adithya-in/Stepper-Motor-shield/README.md

# Stepper Motor Shield — PID Position Control + S-Curve

PIC32MK0512MCJ064 firmware driving a NEMA17 stepper via TB6600 driver with AS5047U
magnetic encoder feedback. Controlled over USB serial (115200 baud) or web dashboard.

**Achieved accuracy: ±1–3 encoder counts = 0.022°–0.066°** (limited by encoder noise floor).

**Clock speed note:** All testing done at **48 MHz** SYSCLK (SPLL from 8 MHz FRC). Target production clock is **10 MHz** (external crystal or lower PLL) — testing pending.

## Project Status

| Area | Status |
|---|---|
| **Firmware** | **Complete** — v6.2.0 tested and verified at 48 MHz (SPLL, 115200 baud, auto-tune capped) |
| **Hardware testing** | **Complete** — NEMA17 + TB6600 characterized at 24V and 31V (see test data below) |
| **Schematic** | **Complete** — KiCad schematic for PIC32MK + TMC2660 + AS5047D + CAN + USB-C (`hardware/Motorshield v6.kicad_sch`) |
| **PCB layout** | **In progress** — routing and layout yet to be finished |
| **10 MHz migration** | **Pending** — clock-dependent formulas need recalculation and retesting |

## Quick Start

```bash
# Flash firmware (via MDB)
rm -rf ~/.mplabcomm
/Applications/microchip/mplabx/v6.30/mplab_platform/bin/mdb.sh flash.mdb

# Connect serial
screen /dev/cu.usbmodemBUR2143200772 115200

# Start dashboard
cd dashboard && npm install && node server.js
# → http://localhost:3000
```

**Power cycle the PKoB4** (unplug/replug USB) after flashing — VCOM gets stuck otherwise.

## Serial Commands

All commands support both **legacy** and **Phase 1** formats. Legacy commands are preserved
so the dashboard and existing scripts continue working.

### Legacy Commands

| Command | Action | Range |
|---|---|---|
| **Position Control** | | |
| `T=<pos>` | Move to absolute position (encoder counts, negative OK) | ±2M |
| `STOP` | Emergency stop — hold position, reset integrator | — |
| `HOME` | Set current position = 0 AND target = 0 | — |
| `ZERO` | Set current position = 0 (leave target unchanged) | — |
| `CLEAR` | Clear fault, re-init motor driver | — |
| **Open-Loop Motor Test** | | |
| `ON` | Enable motor + start spinning at last speed (default 100) | — |
| `OFF` | Disable motor, exit open-loop mode | — |
| `CW` | Set direction clockwise | — |
| `CCW` | Set direction counter-clockwise | — |
| `SPEED=<n>` | Set step rate for open-loop mode | 10–100000 |
| **Motion Profile** | | |
| `MAXV=<n>` | Max velocity | ≥1 steps/s |
| `ACCEL=<n>` | Max acceleration | ≥100 steps/s² |
| `JERK=<n>` | Max jerk (S-curve smoothness) | ≥1000 steps/s³ |
| `PROFILE=S` | S-curve — jerk-limited smooth transitions | — |
| `PROFILE=T` | Trapezoidal — instant acceleration changes | — |
| **PID Tuning** | | |
| `KP=<n>` | Proportional gain | 0–99999 |
| `KI=<n>` | Integral gain | 0–99999 |
| `KD=<n>` | Derivative gain | 0–99999 |
| `TOL=<n>` | At-target tolerance | 0–1000 counts |
| `FT=<n>` | Fault threshold (checked only at rest) | 1–100000 counts |
| **Diagnostics** | | |
| `GET` | One-shot config dump | — |
| **Multi-Point Queue** | | |
| `Q=<pos>,<pos>,...` | Load queue (2–32 points) and start sequential execution | — |
| `DWELL=<ms>` | Set inter-point dwell delay (0–30000 ms) | — |
| `QSTOP` | Abort queue mid-execution | — |

### Phase 1 Commands (Colon-Separated)

| Command | Action | Example |
|---|---|---|
| **Move** | | |
| `m:<speed>:<pos>` | Move to position at given speed (sets MAXV temporarily) | `m:20000:80000` |
| **Enable** | | |
| `en:1` | Enable closed-loop servo (hold current position) | `en:1` |
| `en:0` | Disable motor (release) | `en:0` |
| **Zero** | | |
| `z` | Set current encoder position as zero | `z` |
| **Coil Current (stored)** | | |
| `i:<mA>` | Set coil current limit (stored value, 100–5000 mA) | `i:800` |
| **Microstep (stored)** | | |
| `us:<n>` | Set microstep setting (1/2/4/8/16/32) | `us:16` |
| **PID Gains** | | |
| `pid:<kp>:<ki>:<kd>` | Set proportional, integral, derivative gains | `pid:50:5:10` |
| **Telemetry** | | |
| `tlm:1:<ms>` | Enable status stream at N ms period | `tlm:1:50` |
| `tlm:0` | Disable status stream | `tlm:0` |
| **Multi-Point Queue** | | |
| `q:<pos1>:<pos2>:...` | Load queue (2–32 points) and start sequential execution | `q:10000:20000:30000` |
| `dwell:<ms>` | Set inter-point dwell delay | `dwell:1000` |
| `qstop` | Abort queue mid-execution | `qstop` |
| **Status Query** | | |
| `st?` | One-shot status: position, velocity, error, flags | `st?` |

### Response Format

All commands acknowledge:
```
OK <command>=<value>\r\n
```
or
```
ERR UNKNOWN\r\n
```

### Automatic Status Stream (10 Hz default)

```
P:<position>,E:<error>,V:<velocity>,T:<target>,F:<fault>,M:<moving>,A:<at_target>,Q:<qidx>,QL:<qlen>\r\n
```

Set period with `tlm:1:<ms>` (10–10000 ms), disable with `tlm:0`.

### st? Response (one-shot)

```
p:<position>,v:<velocity>,e:<error>,f:<flags>\r\n
```

Flags bitmask:
- bit 0: fault
- bit 1: moving
- bit 2: at_target
- bit 3: open_loop

### GET Response

```
T=<target>,P=<position>,E=<error>,V=<velocity>,KP=<kp>,KI=<ki>,KD=<kd>,MAXV=<maxv>,ACCEL=<accel>,JERK=<jerk>,TOL=<tol>,FT=<ft>,PROFILE=<S|T>,I=<mA>,US=<microstep>,QLEN=<n>,QIDX=<n>,DWELL=<ms>\r\n
```

## Usage Examples

### Basic Move

```
> en:1           Enable servo (holds current position)
OK en:1
> m:20000:50000  Move to position 50000 at 20000 steps/s
OK m:20000:50000
> st?            Check status
p:50000,v:0,e:0,f:4
```

### Snappy Move (profile feed-forward)

The motor runs at full commanded speed until the stopping distance
(`v² / (2·accel_limit)`) from target, then decelerates hard. The PID
acts as a trim, active only near the target.

```
> PROFILE=T      Trapezoidal profile (instant accel changes)
> ACCEL=500000   Fastest ramp
> MAXV=50000     Top speed
OK PROFILE=T
OK ACCEL=500000
OK MAXV=50000
> m:50000:100000 Move at 50000 steps/s — reaches full speed in ~100ms
OK m:50000:100000
```

### PID Tuning

```
> pid:30:2:5     Set Kp=30, Ki=2, Kd=5
OK pid:30:2:5
> GET            Verify all params
T=10000,P=10000,E=0,V=0,KP=30,KI=2,KD=5,...
```

### Auto-Tune

Relay-based Ziegler-Nichols PID tuning. The motor oscillates around a target, measures ultimate gain (Ku) and period (Tu), then applies:

```
Kp = 0.6 × Ku × 100    (capped at 10000)
Ki = 1.2 × Ku / Tu      (capped at 1000)
Kd = 0.075 × Ku × Tu    (capped at 10000)
```

Send `TUNE` to start. The motor will:
1. Move to current position + 3000 counts
2. Begin relay oscillation (±3000 steps/s relay velocity)
3. After 4+ full cycles, compute PID gains
4. Report: `OK TUNE:Kp=...,Ki=...,Kd=...,amp=...,Tu=...`
5. Return to original target

Caps on auto-tune output prevent excessive gains that cause oscillation — particularly Kd, which can destabilize the motor at high values.

### Telemetry Stream

```
> tlm:1:200      Stream every 200ms
OK tlm:1:200
P:5000,E:-2,V:150,T:5000,F:0,M:0,A:1
P:5000,E:-1,V:0,T:5000,F:0,M:0,A:1
...
> tlm:0          Stop streaming
OK tlm:0
```

### Multi-Point Queue

```
> DWELL=2000     Set 2 second pause between points
OK DWELL=2000
> Q=10000,30000,50000,20000  Load 4-waypoint queue
OK Q=4 points
> ...automatically moves: 10000 → 30000 → 50000 → 20000...
                Each arrival: 2s dwell → next move
> QSTOP          Abort mid-sequence
OK QSTOP
```

Queue is automatically aborted on any manual move (`T=`, `m:`), `STOP`, `OFF`, or `en:0`.

## Accuracy

The system achieves **±1–3 encoder counts** following error at rest.

| Domain | Value |
|---|---|
| 1 encoder count | 360° / 16384 = **0.022°** |
| Typical error | 1–3 counts = **0.022°–0.066°** |
| AS5047U non-linearity | ±0.05° = ~±2 counts |
| With 10mm leadscrew | 1 count ≈ **0.6 µm** |

The error is at the encoder's own noise floor. No further improvement possible
without a higher-resolution encoder.

## Non-Volatile Config

All tuning parameters (Kp, Ki, Kd, max_vel, accel_limit, jerk_limit, tolerance,
fault_thr, profile, coil_current, microstep) are automatically saved to the last
flash page when changed. Persist across power cycles.

- **Flash address**: last page of 512KB (0x1D07F000)
- **Save strategy**: 100ms debounce after last parameter change
- **Integrity**: magic word (0xBEADC0DE) + XOR checksum validated on load
- **Defaults**: used if flash is blank or corrupted

## Motion Profiles

### S-Curve (`PROFILE=S`)
Jerk-limited acceleration:

```
acceleration:  ──/‾‾‾‾‾‾\──  (ramps up/down at JERK rate)
velocity:      ──/‾‾‾‾‾‾\──  (rounded S-shaped transitions)
```

- Jerk limits how fast acceleration changes
- Lower JERK = smoother but slower moves
- Three phases: smooth accel → coast → smooth decel

### Trapezoidal (`PROFILE=T`)
Instant acceleration changes:

```
acceleration:  ──╯‾‾‾‾‾‾╰──  (square wave)
velocity:      ──/‾‾‾‾‾‾\──  (sharp V-shaped ramps)
```

- ACCEL limits the slope of velocity ramps
- Reaches target speed faster than S-curve at same ACCEL
- Higher mechanical stress at transitions

### Profile Feed-Forward (v5.1.2+)

The velocity target is computed from a motion profile, not from PID error.
The motor maintains full commanded speed until the stopping distance from target,
then decelerates at the ACCEL rate. PID adds only a small trim for fine positioning.

```
raw_vel = profile_velocity(error) + pid_trim
profile_vel = max_vel (if far) or linear decel ramp (near target)
pid_trim    = (Kp·error + Ki·integral + Kd·derivative) / 100
```

Anti-windup: integral resets during moves, only active near target.
Auto-tune output capped at Kp≤10000, Ki≤1000, Kd≤10000 to prevent excessive gains.

## Wiring

See [PINOUT.md](docs/PINOUT.md) for complete pin mapping.

### TB6600 Common-Anode Summary

| TB6600 | PIC32MK | Note |
|---|---|---|
| PUL+ | RPB15 (OC1 PWM) | Step pulses, 50% duty |
| DIR+ | RPB14 (GPIO) | LOW=CW, HIGH=CCW |
| ENA+ | RPB13 (GPIO) | **LOW=enable**, HIGH=disable |
| PUL-/DIR-/ENA- | GND | All three tied together |

### TB6600 DIP Switches
- S1/S2/S3: per motor current rating
- S4/S5/S6: S4 ON, S5 ON, S6 ON = 1/32 microstep (6400 steps/rev)

## Dashboard

Web-based UI on port 3000:

```
dashboard/
├── server.js          # Express + WebSocket + serial bridge
├── package.json
└── public/
    ├── index.html     # UI layout
    ├── app.js         # Client logic
    └── styles.css     # Dark theme
```

### Features
- Position display: target / actual with bar indicator
- Status: error, velocity, fault, moving, at-target
- Motor Test card: ON/OFF, CW/CCW, speed slider (up to 50000 steps/s)
- PID sliders: Kp (0–50000), Ki (0–10000), Kd (0–50000)
- Auto-tune button: relay-based Ziegler-Nichols tuning, results shown with slider label sync
- TLM toggle: enable/disable telemetry stream
- Motion Profile: S-curve / Trapezoidal toggle
- ACCEL and JERK number inputs with Set buttons
- MAXV, Tolerance, Fault Threshold inputs
- GET response parsing: position, error, velocity, TOL, FT fields

### Architecture

```
Firmware (PIC32MK) ←→ Serial (115200) ←→ server.js ←→ WebSocket ←→ browser
```

## Firmware Architecture

**Clock:** Currently runs at **48 MHz** (SPLL from 8 MHz FRC). Target for production: **10 MHz** — all clock-dependent formulas (core timer, UART baud, step pulse generation, auto-tune timing) will need recalculation. Testing at 10 MHz is pending.

| Component | Peripheral | Rate | Purpose |
|---|---|---|---|
| Position loop | Timer3 ISR | 1 kHz | Profile → PID trim → smoother → velocity |
| Step generation | OC1 + Timer2 PWM | Variable | Hardware step pulses, 50% duty |
| Encoder | QEI1 | Continuous | AS5047U ABI, 16384 counts/rev |
| UART | UART1 | 115200 baud | Command + telemetry |
| NVM flash | Self-write | On change | Config storage (last flash page) |
| Status stream | Main loop | Configurable | P:E:V:T:F:M:A:Q:QL telemetry |

### Algorithm

```
error = target_pos - encoder_read()

// Profile feed-forward velocity
stop_dist = max_vel² / (2 × accel_limit)     // stopping distance
if abs(error) > stop_dist:
    profile_vel = max_vel × sign(error)       // cruise
else:
    profile_vel = max_vel × error / stop_dist // decel ramp

// PID trim
pid_trim = (Kp×error + Ki×integral + Kd×derivative) / 100

// Combined, fed into accel/jerk smoother
raw_vel = profile_vel + pid_trim

// Accel/jerk smoother → sm_vel → motor steps
```

### Resolution

| Aspect | Value |
|---|---|
| Motor steps/rev | 200 (NEMA17, 1.8°/step) |
| Microstep setting | **1/32** (S4 ON, S5 ON, S6 ON) |
| Steps per revolution | **6400** |
| Encoder PPR | 4096 (AS5047U) |
| Encoder counts/rev (4× QEI) | 16384 |
| Position resolution | 360° / 16384 = **0.022°** per count |

## Voltage-Dependent Limits

At **1/32 microstep** (6400 steps/rev). Firmware accepts any positive value; the
practical limit is set by the motor driver and supply voltage. Empirically determined
guidelines (no load, idle condition):

| Supply Voltage | MAXV (steps/s) | MAXV (RPM) | ACCEL (steps/s²) | Notes |
|---|---|---|---|---|
| 31V | 280,000 | 2,625 | 2,700,000 | Best reliable: 1725 mm/s, Kp=2121 Ki=46. All tests at 48 MHz — 10 MHz testing pending |
| 24V | 250,000 | 2,344 | 3,200,000 | At ≥2.5A coil current, smooth with heating. All tests at 48 MHz — 10 MHz testing pending |
| 12V | 50,000 | 469 | 5,000,000 | Reduced max velocity. All tests at 48 MHz — 10 MHz testing pending |

**31V characterization** (from `docs/TESTS.md`):
- MAXV 300k with 3.2M ACCEL reaches 1902 mm/s (Kp 50–1000, Ki=5, Kd=0)
- Kp >~2000 with Ki > 0 causes oscillation at 31V; best results use moderate Kp
- Trade-off: higher MAXV requires lower ACCEL and vice versa
- Kd was 0 in all 31V tests — derivative not needed with proper Kp/Ki balance

**RPM formula:** `RPM = (steps/s × 60) ÷ steps_per_rev` where `steps_per_rev = 6400` at 1/32.

## Releases

| Tag | Date | Description |
|-----|---|---|
| **v6.2.0** | 2026-06-20 | **Auto-tune caps restored, 31V test data.** Kp≤10000/Ki≤1000/Kd≤10000 caps restored on auto-tune output (prevents oscillation from excessive gains). 31V characterization: 280k MAXV / 2.7M ACCEL / 1725 mm/s reliable belt speed. |
| **v6.1.0** | 2026-06-17 | **SPLL clock (48 MHz), 115200 baud, no command limits.** FRC→SPLL migration. All clock timing fixed. MAXV/ACCEL/JERK upper limits removed. Dashboard TLM toggle. |
| **v6.0.0** | 2026-06-15 | **Phase 1 complete.** `docs/BUGS_AND_LESSONS.md` — full 24+ bug knowledge base. Dashboard activeElement input protection. |
| **v5.2.0** | 2026-06-12 | Multi-point queue (Q=/q:), DWELL, QSTOP, dashboard queue card |
| **v5.1.4** | 2026-06-12 | Dashboard UI ranges match firmware; ACCEL/JERK number inputs; accuracy ±1–3 counts |
| **v5.1.3** | 2026-06-12 | Snappier defaults: MAXV=5000, ACCEL=50000, JERK=500000; ranges increased 5–10× |
| **v5.1.2** | 2026-06-12 | Profile feed-forward velocity; full speed until stopping distance; PID trim only near target |
| **v5.1.1** | 2026-06-12 | NVM flash config: all settings persist across power cycles |
| **v5.1.0** | 2026-06-12 | Phase 1 commands (colon-separated), Kd, configurable telemetry |
| **v5.0.1** | 2026-06-11 | Trapezoidal profile, dashboard toggle, ACCEL/JERK commands |
| **v5.0.0** | 2026-06-11 | PID + S-curve + open-loop test + 6 bug fixes |
| **v4.0.0** | 2026-06-10 | UART serial fixes |
| **v3.1.0** | 2026-06-09 | Open-loop speed control |
| **v3.0.0** | 2026-06-09 | Closed-loop position control |
| **v2.0.0** | 2026-06-09 | Stepper control + encoder |
| **v1.0.0** | 2026-06-08 | Encoder-only firmware |
