adithya-in/Stepper-Motor-shield/hardware/motorshield v6.kicad_pcb

## KiCad design hardware/motorshield v6.kicad_pcb (2026-06-29)

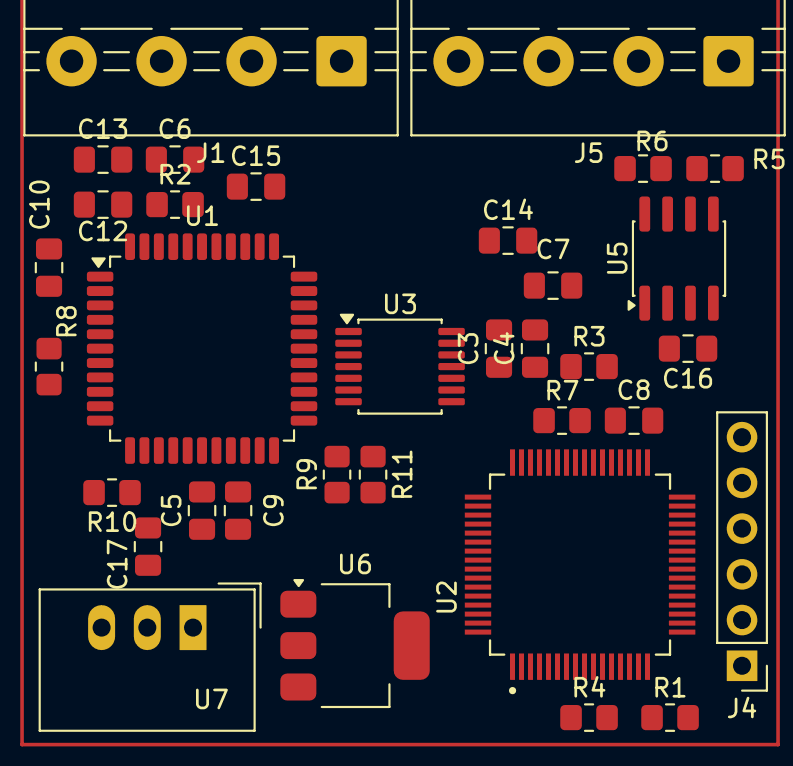
[picture p1: board motorshield v6.kicad_pcb from above]

Board: 2 copper layers, 34 parts (0 on the bottom side), 42 nets, no tracks yet.

Parts:
C3: 10 µF; C_0805_2012Metric_Pad1.18x1.45mm_HandSolder
C4, C5, C6: 0.1 µF; C_0805_2012Metric_Pad1.18x1.45mm_HandSolder
C7, C8: 21 pF; C_0805_2012Metric_Pad1.18x1.45mm_HandSolder
C9, C12, C13: 1µF; C_0805_2012Metric_Pad1.18x1.45mm_HandSolder
C10: 100nF; C_0805_2012Metric_Pad1.18x1.45mm_HandSolder
C14, C16: 100nF/50V; C_0805_2012Metric_Pad1.18x1.45mm_HandSolder
C15: 220nF; C_0805_2012Metric_Pad1.18x1.45mm_HandSolder
C17: 470nF; C_0805_2012Metric_Pad1.18x1.45mm_HandSolder
J1, J5: Conn_01x04; TerminalBlock_MaiXu_MX126-5.0-04P_1x04_P5.00mm
J4: Conn_01x06; PinHeader_1x06_P2.54mm_Vertical
R1, R4, R7: 1K; R_0805_2012Metric_Pad1.20x1.40mm_HandSolder
R2: 10K; R_0805_2012Metric_Pad1.20x1.40mm_HandSolder
R3: 0 Ω; R_0805_2012Metric_Pad1.20x1.40mm_HandSolder
R5, R6: 120; R_0805_2012Metric_Pad1.20x1.40mm_HandSolder
R8, R11: 0R075; R_0805_2012Metric_Pad1.20x1.40mm_HandSolder
R9, R10: 10R; R_0805_2012Metric_Pad1.20x1.40mm_HandSolder
U1: TMC2660; LQFP-44_10x10mm_P0.8mm
U2: PIC32MK0512MCJ064T-I_PT; PIC32MK0512MCJ064-I_PT
U3: AS5047D; TSSOP-14_4.4x5mm_P0.65mm
U5: MCP2562-E-SN; SOIC-8_3.9x4.9mm_P1.27mm
U6: AMS1117-3.3; SOT-223-3_TabPin2
U7: TSR_1-2450; Converter_DCDC_TRACO_TSR-1_THT

Connections:
+3.3V: C3.1, C4.1, C5.1, C9.1, C16.1, J4.2, R2.2, U1.40 (VCC_IO), U2.10 (VDD), U2.19 (AVDD), U2.26 (VDD), U2.38 (VDD), U2.57 (VDD), U3.12 (VDD3V3), U5.5 (Vio), U6.2 (VO)
+5V: U6.3 (VI), U7.3 (Vout)
+40V: C10.2, C12.1, C13.1, C14.1, C15.1, J5.4, U1.4 (VSA), U1.30 (VSB), U1.36 (VS), U3.11 (VDD), U7.1 (Vin)
/CAN1_RX: U2.36 (AN46/CVD46/RPA14/RA14), U5.4 (RXD)
/CAN1_TX: U2.37 (AN47/CVD47/RPA15/RA15), U5.1 (TXD)
/CANH: J5.2, R6.2
/CANL: J5.1, R5.2
/CSN: U1.18 (~CS), U2.32 (FLT15/RPB4/SCL2/RB4)
/Clock: U2.15 (PGD3/VREF-/OA2IN-/AN2/C2IN1-/RPB0/CTED2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), U3.2 (CLK)
/DIR: U1.41 (DIR), U2.2 (RPB14/PWM1H/RB14)
/ENABLE: U1.19 (~EN), U2.63 (RPB13/PWM2L/CTPLS/RB13)
/Encoder A: U2.4 (AN19/CVD19/RPG6/PWM7L/RG6), U3.7 (A)
/Encoder B: U2.5 (AN18/CVD18/RPG7/PWM7H/RG7), U3.6 (B)
/MCLR: J4.1, R1.2, U2.7 (~MCLR)
/Miso: U2.17 (PGC1/OA1IN+/AN4/C1IN1+/C1IN3-/C2IN3-/RP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), U3.3 (MISO)
/Mosi: U2.16 (PGC3/OA1OUT/VREF+/AN3/C1IN4-/C4IN2-/RPB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), U3.4 (MOSI)
/Motor A+: J1.4, U1.2 (OA1), U1.3 (OA1), U1.7 (OA1), U1.8 (OA1)
/Motor A-: J1.3, U1.5 (OA2), U1.6 (OA2), U1.10 (OA2), U1.11 (OA2)
/Motor B+: J1.2, U1.26 (OB1), U1.27 (OB1), U1.31 (OB1), U1.32 (OB1)
/Motor B-: J1.1, U1.23 (OB2), U1.24 (OB2), U1.28 (OB2), U1.29 (OB2)
/NC: J4.6, U1.1 (n.c.), U1.33 (n.c.), U3.8 (W/PWM), U3.9 (V), U3.10 (U), U3.14 (I/PWM)
/OSCI: C8.1, U2.39 (OSCI/CLKI/AN49/CVD49/RPC12/RC12)
/OSCO: R3.2, U2.40 (OSCO/CLKO/RPC15/RC15)
/SCK: U1.16 (SCK), U2.43 (PGD2/RPB5/SDA1/RB5)
/SDI: U1.15 (SDI), U2.46 (OA5OUT/AN25/CVD25/C5IN4-/RPB7/SCK1/INT0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)
/SDO: U1.14 (SDO), U2.44 (PGC2/RPB6/SCL1/RB6)
/STEP: U1.42 (STEP), U2.3 (RPB15/PWM1L/RB15)
/cs: U2.18 (PGD1/OA1IN-/AN5/CTCMP/C1IN1-/RTCC/RPB3/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), U3.1 (~CS)
GND: C3.2, C4.2, C5.2, C6.2, C7.2, C8.2, C9.2, C10.1, C12.2, C13.2, C14.2, C16.2, C17.1, J4.3, J5.3, R4.1, R7.2, R8.2, R11.2, U1.17 (GND), U1.39 (GND), U1.43 (TST_MODE), U1.44 (GND), U2.9 (VSS), U2.20 (AVSS), U2.25 (VSS), U2.41 (VSS), U2.56 (VSS), U3.5 (TST), U3.13 (GND), U5.2 (VSS), U5.8 (STBY), U6.1 (GND), U7.2 (GND)
unnamed: C7.1, R3.1
unnamed: C6.1, R1.1, R2.1
unnamed: C17.2, U1.13 (5VOUT)
unnamed: R8.1, R10.2, U1.9 (BRA)
unnamed: R9.2, R11.1, U1.25 (BRB)
unnamed: R10.1, U1.12 (SRA)
unnamed: R9.1, U1.22 (SRB)
unnamed: C15.2, U1.35 (VHS)
unnamed: R4.2, U2.1 (TCK/RPA7/PWM4L/RA7), U2.11 (AN10/CVD10/RPA12/FLT13/RA12), U2.12 (AN9/CVD9/RPA11/FLT14/RA11), U2.13 (OA2OUT/AN0/C2IN4-/C4IN3-/RPA0/RA0), U2.14 (OA2IN+/AN1/C2IN1+/RPA1/RA1), U2.31 (TDI/DAC2/AN26/CVD26/RPA8/SDA2/RA8), U2.33 (OA5IN+/AN24/CVD24/C5IN1+/C5IN3-/RPA4/RA4), U2.64 (TDO/PWM4H/RA10)
unnamed: R7.1, U2.21 (OA3OUT/AN6/CVD6/C3IN4-/C4IN1+/C4IN4-/RP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), U2.22 (OA3IN-/AN7/CVD7/C3IN1-/C4IN1-/RPC1/RC1), U2.23 (OA3IN+/AN8/CVD8/C3IN1+/C3IN3-/RPC2/FLT3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), U2.24 (AN11/CVD11/C1IN2-/FLT4/RC11), U2.27 (AN12/CVD12/C2IN2-/C5IN2-/FLT5/RE12), U2.28 (AN13/CVD13/C3IN2-/FLT6/RE13), U2.29 (AN14/CVD14/RPE14/FLT7/RE14), U2.30 (AN15/CVD15/RPE15/FLT8/RE15), U2.34 (AN40/CVD40/RPE0/RE0), U2.35 (AN41/CVD41/RPE1/RE1), U2.42 (RD8), U2.45 (DAC1/AN48/CVD48/RPC10/RC10), U2.47 (SOSCI/RPC13/RC13), U2.50 (TRCLK/RPC6/PWM6H/RC6), U2.51 (TRD0/RPC7/PWM6L/RC7), U2.52 (TRD1/RPC8/PWM5H/RC8), U2.53 (TRD2/RPD5/PWM9H/RD5), U2.54 (TRD3/RPD6/PWM9L/RD6), U2.55 (RPC9/PWM5L/RC9), U2.58 (RPF0/PWM8H/RF0), U2.59 (RPF1/PWM8L/RF1)
unnamed: U2.6 (AN17/CVD17/RPG8/RG8), U2.8 (AN16/CVD16/RPG9/FLT12/RG9)
unnamed: R6.1, U5.7 (CANH)
unnamed: R5.1, U5.6 (CANL)
