adithya-in/Stepper-Motor-shield/(commit log)

2026-06-06 Initial commit: AS5047U encoder QEI + UART firmware for PIC32MK MCJ Curiosity Pro
2026-06-06 Add web dashboard, change UART baud to 115200
2026-06-08 Fix UART serial output: PB1DIV clock divider, PPS lock bits, and baud rate
    Bugs fixed (in order of discovery):
    1. CFGCON address was 0xBF80F610 (nonexistent) → changed to 0xBF800000
    - This caused PPS unlock to crash the MCU, no code ever ran
    2. PB1CLK defaults to SYSCLK/2 (4 MHz), not 8 MHz
    - Hardcoded PB_CLOCK=8000000 gave wrong baud (8.5% error at 38400)
    - Changed to PB_CLOCK=4000000 with UART_BAUD=19200 (0.16% error)
    3. PPS unlock only cleared IOLOCK (bit 13), now clears PGLOCK+PMDLOCK too
    - On PIC32MK, PPS has three separate lock bits (11, 12, 13)
    4. #pragma config was unreliable for FWDTEN/FDMTEN (didn't disable WDT)
    - Replaced with direct section-based config (actual f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
    [newxc32_newfile.c]
2026-06-09 v2.0.0: TB6600 stepper control + encoder feedback + full test documentation
    - Add OC1-based step generation (Timer2 PWM, RPB15, 10 kHz)
    - Add direction control (RPB14) and enable (RPB13, LOW=enable)
    - CW 5s → CCW 5s test loop with UART RPM reporting
    - Fix ENA polarity for common-anode wiring (ENA_ON=0)
    - docs/TESTS.md: full journey from Arduino prototyping through PIC32MK
    - docs/PINOUT.md: complete wiring reference with physical pin numbers
    - tests/arduino/: Arduino validation code (.ino + PlatformIO)
    - Update README.md and CHANGELOG.md
    [main.cpp, motor_test.ino, newxc32_newfile.c]
2026-06-09 v3.0.0: Closed-loop position control + PI controller + web dashboard
    - Timer3 position control loop at 1 kHz with PI controller
    - OC1/Timer2 variable-rate step generation (10-5000 steps/s)
    - Following error computation with configurable fault threshold
    - Software zero reference (HOME command)
    - Point-to-point moves with configurable position tolerance
    - Coil current limit enforced via MAXV cap
    - UART command set: T=<pos> HOME STOP CLEAR KP KI MAXV TOL FT
    - Dashboard rewritten for position control with tuning sliders
    [newxc32_newfile.c]
2026-06-09 v3.1.0: Speed control mode — motor spins from browser slider
    - Replace closed-loop position control with open-loop speed control
    - Commands: ON OFF CW CCW SPEED <steps/s>
    - Dashboard: RPM gauge, speed slider (0-10000), direction toggle, start/stop
    - Encoder RPM feedback displayed live in browser
    - Clean build, no errors
    [newxc32_newfile.c]
2026-06-09 Auto-start motor at 2000 steps/s CW on boot
2026-06-09 Add encoder position display to dashboard
2026-06-09 Single-char commands for instant motor control (0=off 1=on 2=cw 3=ccw)
2026-06-09 Fix: configure RPG8 as digital input for UART RX
    [newxc32_newfile.c]
2026-06-10 v4.0.0: UART serial fixes — U1RXR=10, URXEN=1, OERR handler, SPEED parsing fix
    UART fixes required for reliable serial communication on PIC32MK Curiosity Pro:
    - U1RXR = 10 (was 1) — correct PPS input mapping for RPG8 as U1RX
    - U1STAbits.URXEN = 1 — explicitly enable receiver (not set by UARTEN)
    - uart_clear_oerr() — clear overrun errors and flush RX FIFO
    - Single-char commands only at rx_idx == 0 — prevents digit '0'
    in SPEED 5000 from matching STOP handler
    - README: commands reference, UART fix table, common-anode wiring
    warning, tool reservation instructions
    - CHANGELOG: v4.0.0 with all fixes and key lessons learned
    - PINOUT: clarified common-anode wiring caveat
    [newxc32_newfile.c]
2026-06-10 Fix PID position control: interrupt, fault, acceleration, and hold fixes
    ## Bugs fixed
    1. **Timer3 ISR never fired** — IFS0/IEC0 used bit 12 (INT4) instead
    of bit 14 (Timer3) on PIC32MK0512MCJ064. PID control loop was
    completely dead since firmware inception.
    2. **Missing global interrupt enable** — no __builtin_enable_interrupts()
    call. Added in main() after fixing bit 14.
    3. **Fault threshold kills moves** — fault_thr (500 steps) triggered
    instantly on large T= commands (e.g. T=100000 from position 0).
    Changed to only check fault when at_target=1 (motor was at position
    and got disturbed), not during active movement.
    4. **Motor disabled at target** — motor_disa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
    [newxc32_newfile.c]
2026-06-11 Full documentation: README + CHANGELOG with all commands, profiles, wiring
2026-06-12 v5.1.0 — Phase 1 commands: colon-separated opcode format, Kd, configurable telemetry
2026-06-12 v5.1.1 — NVM flash config: parameters persist across power cycles
2026-06-12 v5.1.2 — profile feed-forward: full speed until stopping distance, PID trim only near target
2026-06-12 v5.1.3 — snappier defaults: MAXV=5000, ACCEL=50000, JERK=500000; range bumps: MAXV→50000, ACCEL→500000, JERK→10M
    [newxc32_newfile.c]
2026-06-12 v5.1.4 — dashboard: UI ranges match new firmware (MAXV=50000, ACCEL=500000, JERK=10M); ACCEL/JERK changed to number inputs with Set button; server.js parses ACCEL/JERK/MAXV/KD/I/US from GET
2026-06-12 fix: make status regex backward-compatible, Q= parsing handles spaces
    [newxc32_newfile.c]
2026-06-15 v5.3.0 — auto-tune: relay-based Ziegler-Nichols PID tuning, Kd, dashboard UI
2026-06-15 v6.0.0 — Phase 1 complete: BUGS_AND_LESSONS.md knowledge base, dashboard activeElement fix
2026-06-15 Revert "raise MAXV limit 50000 -> 100000 in firmware and dashboard"
    This reverts commit d088e7e43fe713ce4c691078f8c89634434a5e24.
    [newxc32_newfile.c]
2026-06-15 fix: pending-field guard prevents telemetry overwrite after Set; add units to dashboard labels
    [newxc32_newfile.c]
2026-06-15 fix: CONFIG_DATA_WORDS 12->11 (struct has 11 fields, 12th was garbage breaking checksum)
    [newxc32_newfile.c]
2026-06-17 v6.1.0: SPLL clock (48 MHz), 115200 baud, no command limits
    Clock architecture migrated from FRC to SPLL for reliable 115200 baud.
    All clock-dependent timing formulas fixed (msleep, motor_set_speed,
    auto-tune Tu, config save). Removed hard upper limits on MAXV, ACCEL,
    JERK. Added flash.mdb MDB script. Dashboard: TLM toggle, 115200 baud
    default, GET field parsing. Docs: microstep 1/32 corrections.
    [main.cpp, newxc32_newfile.c]
2026-06-17 docs: add motor test results (coil current characterization at 24V, 190k steps/s)
2026-06-18 docs: update motor test data with test bench data1 (250k steps/s, 3.2M accel)
2026-06-18 docs: add belt speed and RPM columns to motor test table
2026-06-18 ui: show auto-tune results (Kp/Ki/Kd/amp/Tu) on dashboard next to Tune button
2026-06-19 fix: auto-tune values now update PID slider labels for fine-tuning
2026-06-19 fix: PID slider ranges match firmware (Kp 0-10000, Ki 0-1000, Kd 0-10000)
2026-06-19 remove PID auto-tune caps, raise dashboard PID slider ranges to 50000
2026-06-20 v6.2.0: restore auto-tune caps (Kp≤10000/Ki≤1000/Kd≤10000), add 31V test data
    - Restore original v5.3.0 auto-tune output caps on Kp (≤10000),
    Ki (≤1000), Kd (≤10000) to prevent excessive gains
    - Add 31V motor test results from motorshieldtest.pdf:
    - 11 test rows sweeping ACCEL/MAXV/Kp/Ki
    - Best result: 280k MAXV / 2.7M ACCEL / 1725 mm/s
    - Kp >~2000 with Ki > 0 causes oscillation at 31V
    - Update voltage-dependent limits table with 31V data
    - Update dashboard features and PID ranges in README
    - Regenerate DOCUMENTATION.pdf with all new content
    [newxc32_newfile.c]
2026-06-29 add KiCad PCB and schematic files (motorshield v6)
    [Motorshield v6.kicad_sch, motorshield v6.kicad_pcb]
2026-06-29 add project status report, update 31V test data table, regenerate PDF
2026-06-29 add project report with TOC, status table, 31V test data, pin connections
